puzzle/lightning-beer-tap/schematic/output.pdf

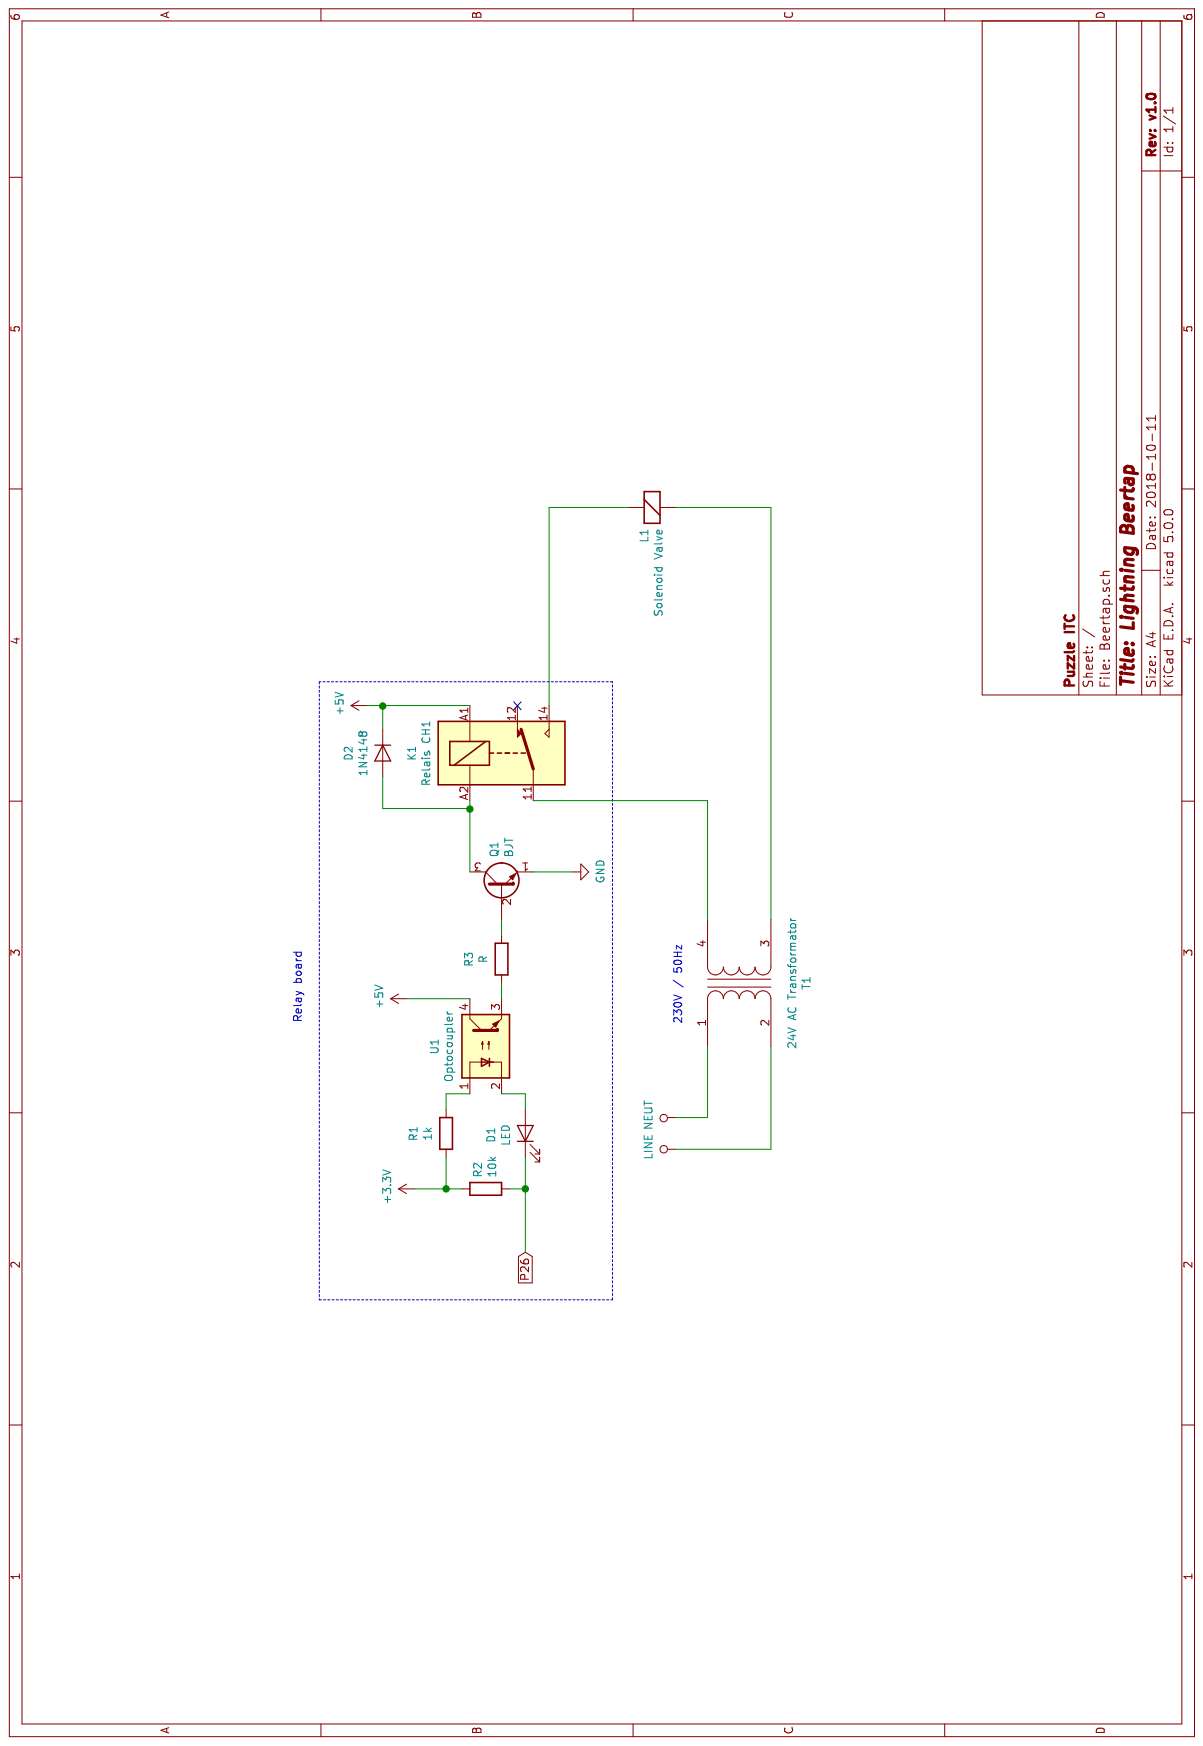
[picture p5: page 1]
