puzzle/lightning-beer-tap/schematic/Beertap.kicad_pcb

## KiCad design electronica/pcb/shield ORP.sch


Parts:
C3: C0.1uF; C_Disc_D5.0mm_W2.5mm_P2.50mm
C4, C6: 0.1uF; C_Disc_D5.0mm_W2.5mm_P2.50mm
C5, C7: 10uF; CP_Radial_D7.5mm_P2.50mm
D1: LED; LED_D3.0mm
J1: ConArduino; Socket_Strip_Straight_1x03_Pitch2.54mm
J2: Con(-5v); Socket_Strip_Straight_1x03_Pitch2.54mm
J3: Conn_Coaxial; BNC_Socket_TYCO-AMP_LargePads
R1, R2: 30K 1%; R_Axial_DIN0204_L3.6mm_D1.6mm_P7.62mm_Horizontal
R3: 75K 1%; R_Axial_DIN0204_L3.6mm_D1.6mm_P5.08mm_Vertical
R4: 1K; R_Axial_DIN0204_L3.6mm_D1.6mm_P7.62mm_Horizontal
SW1: SW_DIP_x01; SW_DIP_x1_W7.62mm_Slide_LowProfile
U2: TL032; SO-8_5.3x6.2mm_Pitch1.27mm

Connections:
+5V: C3.2, C5.1, J1.2, J2.3, R4.1, U2.8 (V+)
-VDC: C4.2, C7.2, J2.1, R3.2, U2.4 (V-)
GND: C3.1, C4.1, C5.2, C6.2, C7.1, D1.1 (K), J1.3, J2.2, J3.2 (Ext), SW1.2, U2.5 (+)
unnamed: C6.1, R1.2, U2.1, U2.2 (-)
unnamed: D1.2 (A), R4.2
unnamed: J1.1, R2.1, U2.7
unnamed: J3.1 (In), SW1.1, U2.3 (+)
unnamed: R1.1, R2.2, R3.1, U2.6 (-)

Notes on the sheet:
gnd
out
