puzzle/lightning-beer-tap/(threads)

Thread 4 (2022-05-29):

Zeus Application Requirementd

BenGWeeks, 2022-05-29:
Hi there,

Not an "issue" as such but no discussion area.

Is the intension that the Zeus Application is installed on the same Raspberry Pi as this solution, or, a Bitcoin/Lightning that this solution communicates too? (E.g. Umbrel)

Regards,

Ben

Thread 5 (2022-06-25):

Where can you get the cooler?

kiwiidb, 2022-06-25:
Didn't find any information about this, and it's hard to find online.

karliatto, 2022-07-05:
I think you could use the one that they sell in the same shop as the tap with solenoide valve.

https://schankanlagenhandel.eu/en/coolers/top-counter-coolers1/upper-counters-dry-cooler-web-25

But probably you could find something similar in your local area.

I think the connectors for the pipes are standards, but not 100% sure.

kiwiidb, 2022-09-08:
I've tried this type of model and it doesn't fit the valve part unfortunately..

karliatto, 2022-09-08:
@kiwiidb Did you try to open and connect it from inside the cooler?
 I have tried with not exactly the one from this provider but very very similar one and that is what I had to do, and it fits perfectly.

kiwiidb, 2022-09-08:
We tried to open up the Lindr Pygmy cooler but weren't able to do that... We couldn't get it open.

karliatto, 2022-09-08:
Lindr Pygmy is the one I have and you have to open in order to connect it to the valve. You have to screw it from few different parts and then pull up. It is not very intuitive but it is doable. I can send you some pictures.

kiwiidb, 2022-09-08:
Sent you a DM on Twitter, let's continue there. Thanks!
