puzzle/lightning-beer-tap/(commit log)

2018-10-06 Add start skript prototype
2018-10-11 Increase large beer flow to 6sec
2018-10-16 Add schematics and restart function
    [Beertap.kicad_pcb, Beertap.sch]
2018-10-16 Add compiled schematic pdf
2019-08-13 Execute command in thread to not block
2019-08-13 Only set up pin that we are really going to use
